craigyjp/AX-80-Editor-Encoders-ESP32-S3/schematics/AX80logic.pdf

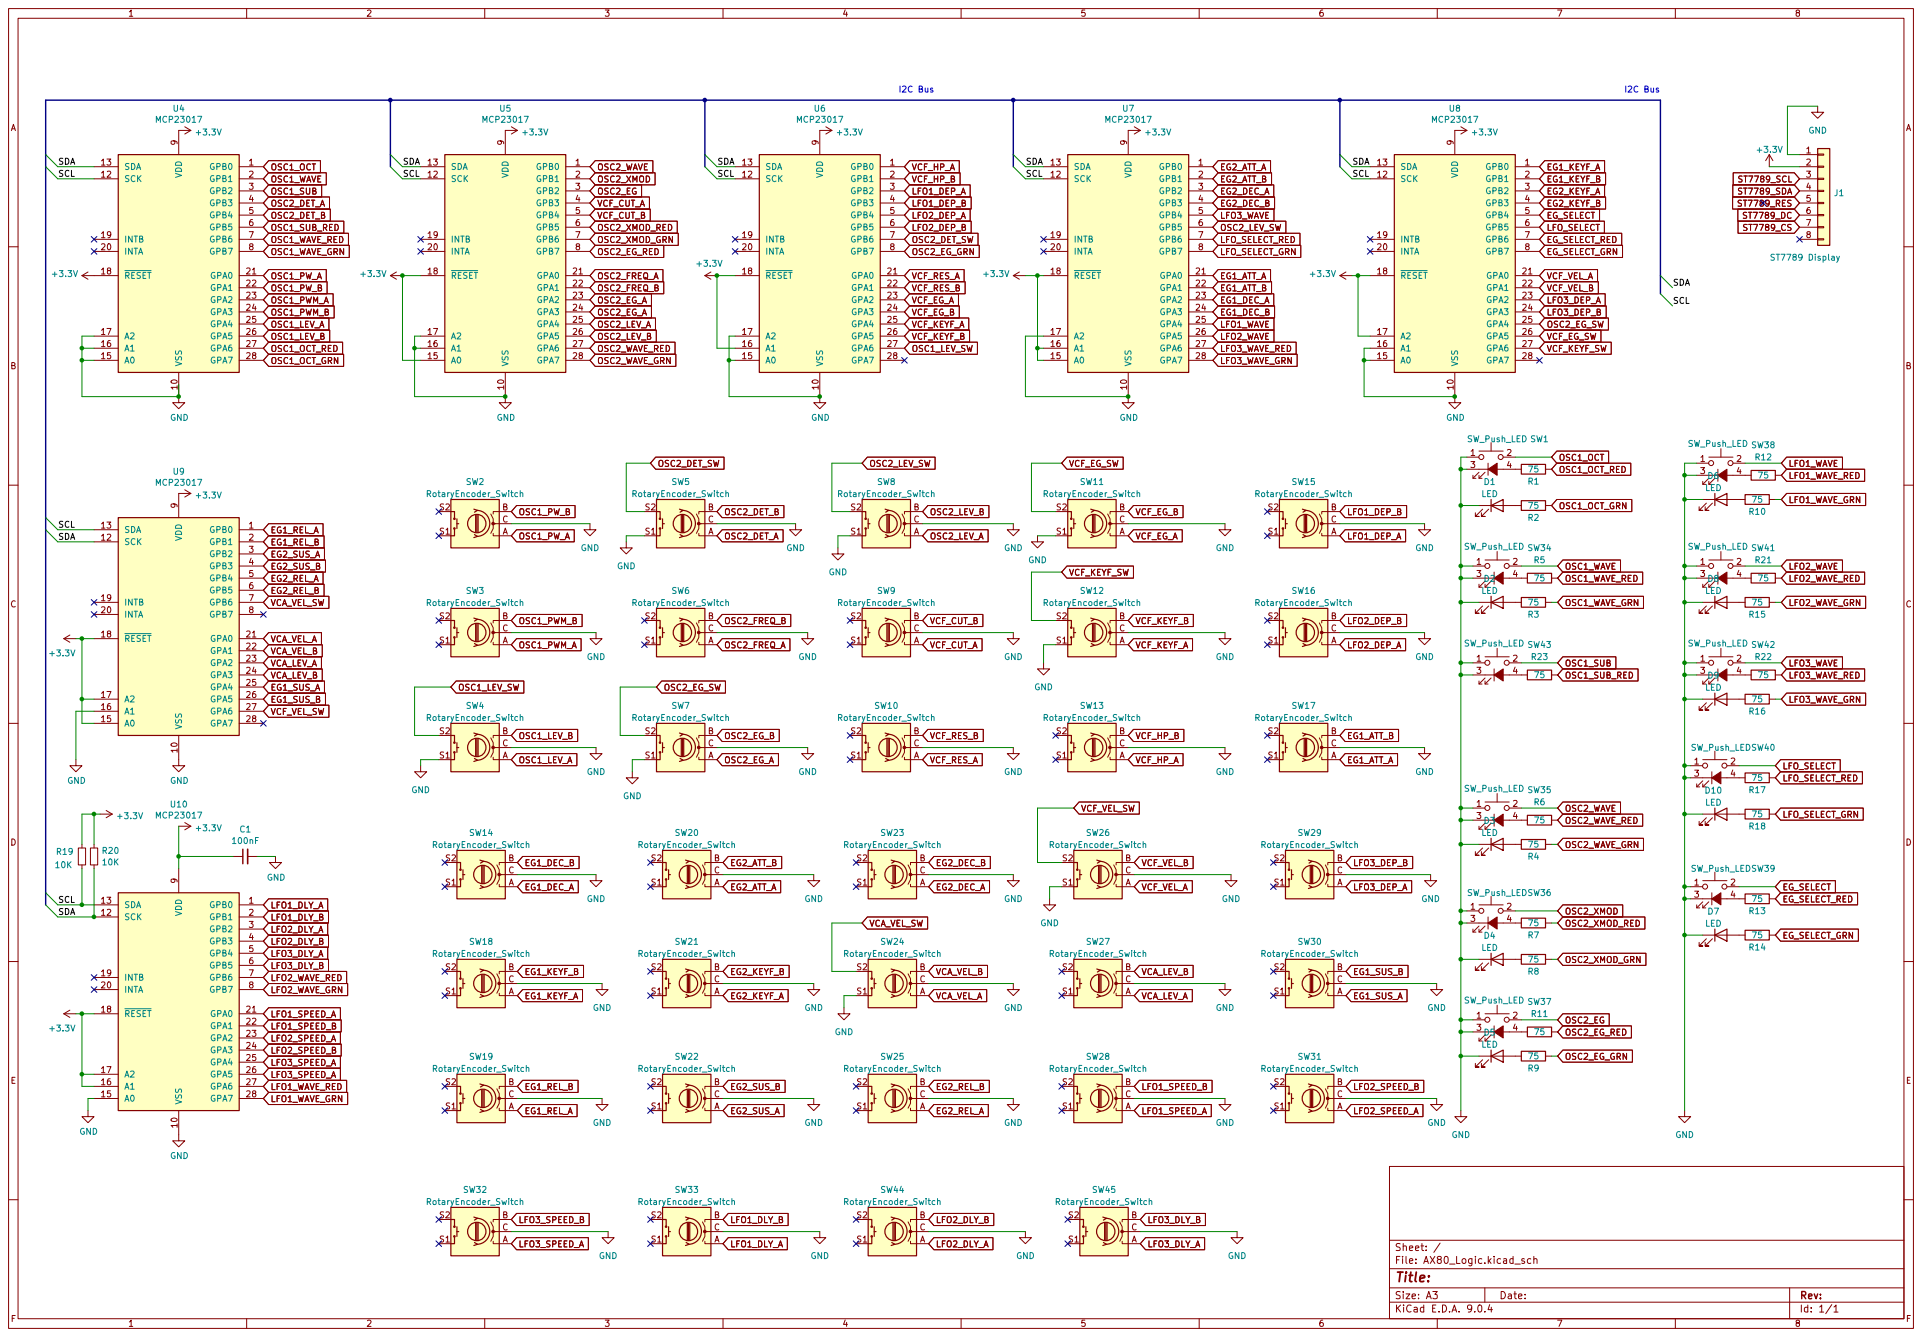
[picture p2: page 1]
