craigyjp/AX-80-Editor-Encoders-ESP32-S3/schematics/AX80processor.pdf

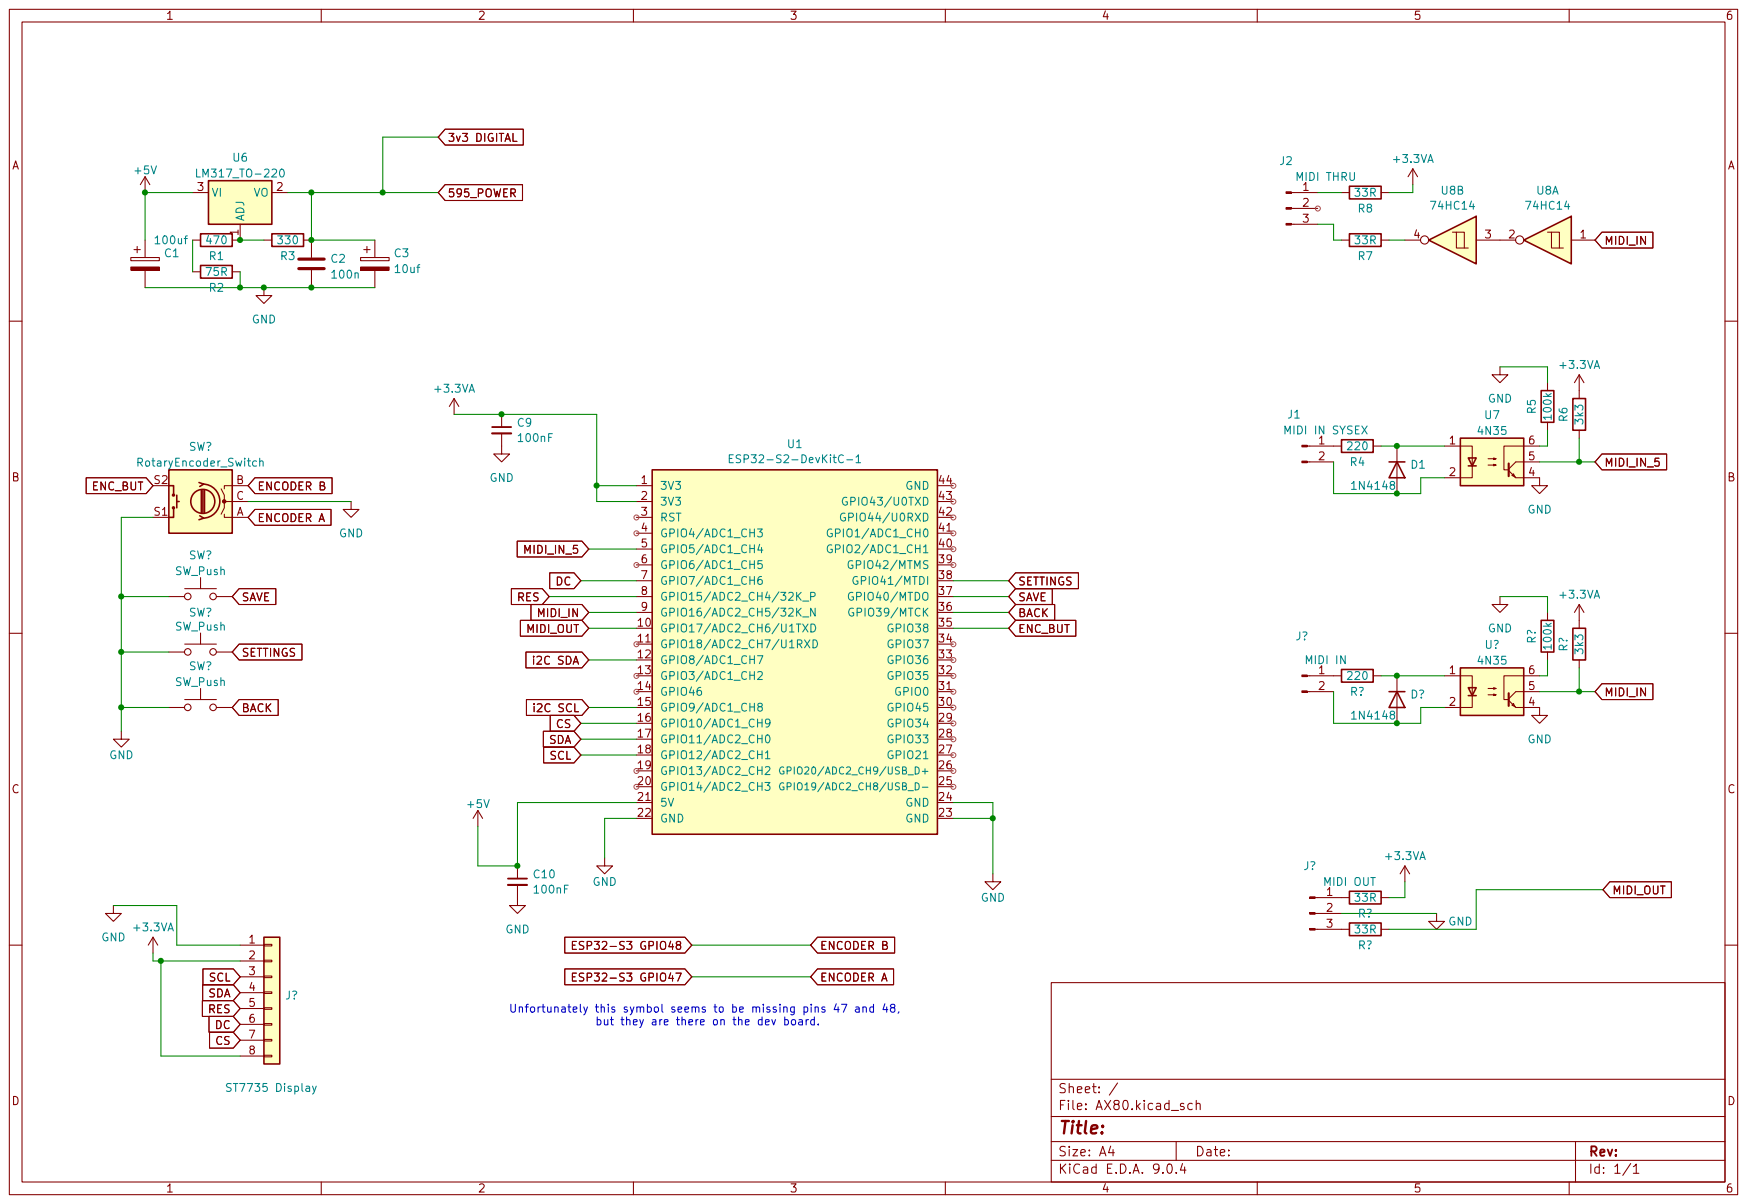
[picture p3: page 1]
