craigyjp/AX-80-Editor-Encoders-ESP32-S3/src/Constants.h

const char* VERSION = "V1.4";

const byte USB_CHANNEL_OFFSET = 1;  // Add 1 to USB channels to make them 1-based
#define RE_READ -9
#define NO_OF_PARAMS 50
const char* INITPATCHNAME = "Initial Patch";
#define HOLD_DURATION 1000
const uint32_t CLICK_DURATION = 250;
#define PATCHES_LIMIT 999
String INITPATCH = "A Piano, 8, 1, 99, 4, 1, 99, 34, 51, 1, 0, 49, 2, 32, 63, 8, 57, 16, 58, 11, 1, 0, 0, 4, 0, 17, 0, 3, 0, 0, 0, 4, 1, 10, 54, 0, 11, 50, 14, 23, 11, 99, 47, 1, 99, 85";

// Create and populate the array with data

const String factoryKL[32] = {
  "A Piano, 8, 1, 99, 4, 1, 99, 34, 51, 1, 0, 49, 2, 32, 63, 8, 57, 16, 58, 11, 1, 0, 0, 4, 0, 17, 0, 3, 0, 0, 0, 4, 1, 10, 54, 0, 11, 50, 14, 23, 11, 99, 47, 1, 99, 85",
  "E Piano, 8, 2, 34, 10, 0, 58, 36, 50, 1, 0, 50, 1, 99, 53, 10, 53, 58, 87, 15, 7, 12, 0, 4, 0, 12, 0, 4, 0, 20, 0, 4, 1, 3, 43, 0, 12, 63, 0, 4, 0, 16, 0, 1, 99, 99",
  "Clavichord, 16, 2, 99, 0, 0, 99, 4, 71, 1, 1, 78, 1, 32, 50, 23, 75, 23, 35, 0, 0, 52, 2, 4, 0, 90, 0, 3, 0, 0, 0, 4, 1, 0, 44, 0, 0, 0, 0, 0, 70, 0, 0, 1, 91, 99",
  "Harpsichord, 8, 3, 99, 0, 1, 82, 19, 29, 3, 1, 42, 1, 99, 74, 32, 80, 99, 1, 0, 0, 49, 0, 4, 0, 43, 0, 2, 0, 61, 0, 2, 1, 0, 27, 0, 5, 53, 0, 97, 0, 0, 87, 1, 54, 26",
  "Toy Piano, 4, 0, 0, 0, 1, 99, 36, 47, 2, 0, 72, 0, 99, 70, 6, 0, 57, 0, 99, 16, 0, 0, 4, 0, 81, 0, 3, 0, 44, 0, 1, 1, 1, 39, 0, 25, 71, 0, 0, 0, 0, 48, 1, 57, 77",
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
  "Reiteration, 62, 2, 2, 99, 99, 1, 99, 0, 50, 3, 1, 99, 1, 99, 68, 17, 75, 68, 99, 0, 14, 50, 0, 3, 0, 0, 76, 0, 19, 90, 0, 61, 46, 99, 50, 0, 2, 99, 50, 0, 3, 99, 72, 0, 79, 0",
  "Rise, 63, 0, 1, 0, 0, 1, 99, 0, 50, 1, 0, 50, 1, 99, 86, 74, 25, 71, 0, 10, 4, 99, 99, 0, 0, 0, 99, 0, 0, 0, 0, 23, 27, 8, 1, 0, 3, 0, 81, 0, 3, 0, 49, 0, 81, 0",
};
