craigyjp/AX-80-Editor-Encoders-ESP32-S3/(commit log)

2025-11-14 Update README with ESP32-S3 details
    Added information about the ESP32-S3 Dev Kit and littleFS usage.
2025-11-14 Added schematics
2025-11-15 Added half step mode for 15 pulse encoders
